manuelmohr/PhotoStick/resources/Feuer.bmp

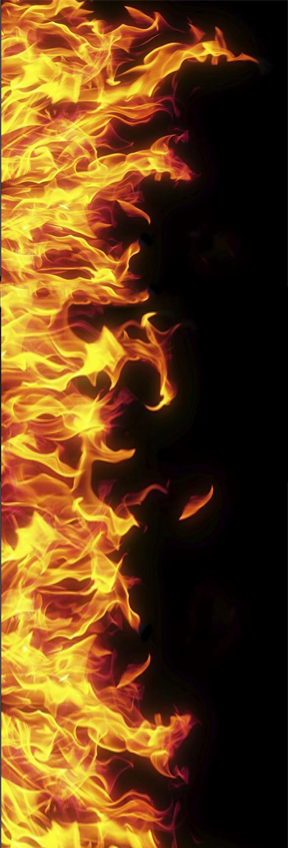
resources/Feuer.bmp
