manuelmohr/PhotoStick/resources/on.jpg

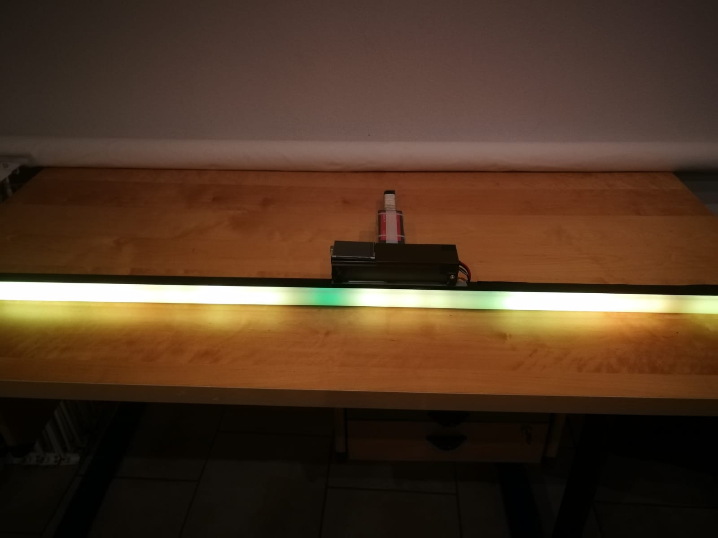
resources/on.jpg
