manuelmohr/PhotoStick/resources/spider1.jpg

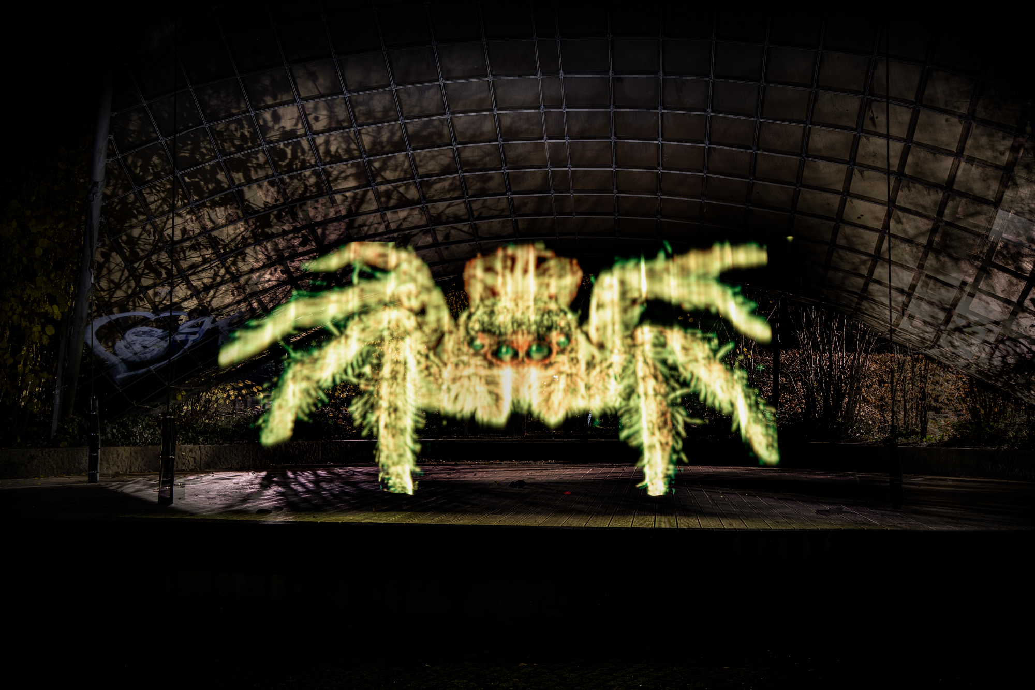
resources/spider1.jpg
