manuelmohr/PhotoStick/i18n.hpp

#ifndef I18N_HPP
#define I18N_HPP

#include "config.hpp"

#ifdef LANGUAGE_GERMAN
/* German */
#define STR_PROJECT_NAME "Photostick"
#define STR_IMAGE "Bild"
#define STR_CREATIVE "Kreativ"
#define STR_BACK "Zurueck"
#define STR_FORWARD "Weiter"
#define STR_START "START"
#define STR_LIGHT_1_SEC "Leuchten 1 Sek"
#define STR_BLINK_1_SEC "Blinken 1 Sek"
#define STR_MARQUEE "Laufband"
#define STR_CONFIG "Konfig"
#define STR_BRIGHTNESS "Helligkeit"
#define STR_SPEED "Geschwindigkeit"
#define STR_COUNTDOWN "Countdown"
#define STR_REPETITIONS "Wiederholungen"
#else
/* English */
#define STR_PROJECT_NAME "Photostick"
#define STR_IMAGE "Image"
#define STR_CREATIVE "Creative"
#define STR_BACK "Back"
#define STR_FORWARD "Continue"
#define STR_START "START"
#define STR_LIGHT_1_SEC "Light 1 sec"
#define STR_BLINK_1_SEC "Blink 1 sec"
#define STR_MARQUEE "Marquee"
#define STR_CONFIG "Config"
#define STR_BRIGHTNESS "Brightness"
#define STR_SPEED "Speed"
#define STR_COUNTDOWN "Countdown"
#define STR_REPETITIONS "Repetitions"
#endif

#endif

// vim: et ts=2
