manuelmohr/PhotoStick/(commit log)

2018-03-18 Increase LED count to 288.
2018-03-19 Add simple GUI to switch between two animations.
2018-03-19 First prototype that seems to work.
2018-03-20 Add first prototype with BMP hack.
    We align BMP image data to 512 bytes and then read two Flash blocks
    (1024 bytes) at once. This gives us a whole column of the target
    picture in 16-bit color format.
2018-04-02 WIP: Switch to GUIslice lib.
2018-08-12 Disable GUI stuff for now, SD card → LED works with Pix format.
2018-12-27 Prepare for switch to Arduino Mega.
2019-03-02 Extend and fix GUI. Work-in-progress.
    [gui.hpp]
2019-05-11 Fix state machine, factor out backlight switching.
    [Pixelstick.ino, gui.hpp, gui.ino]
2019-05-28 Fix display for more than six files.
    [gui.ino]
2019-12-07 Add more pictures an sample shots.
2020-06-14 Upgrade Arduino release, fix compiler warnings.
    [gui.ino]
2020-06-14 Rotate display to match new mounting.
2020-06-14 Make display flip configurable.
    [gui.ino]
2020-06-14 Fix BMP input code; tested with 16, 24, and 32-bit from GIMP.
    [bmp.ino]
2020-06-28 Use SdFat instead of SD. Loading row 36 ms → 26 ms.
2020-06-28 Optimize SD loading. Loading row 26 ms → 5 ms.
2020-06-28 Fix: correctly close file after usage.
    [Photostick.ino]
2020-06-28 Fix: set num in constructor.
    [Photostick.ino]
2020-11-15 Enable optional voltage monitoring.
2020-12-24 Make voltage monitoring really optional.
2020-12-24 Support more than 10 files, add buttons to scroll file list.
2020-12-25 Disable voltage monitoring by default.
2021-02-04 Fix type of delay variable.
    [Photostick.ino]
